mansoorzamankhan/LORAWAN_project/Reports/2023-05-19 LoraWan Project Weekly Repot.docx

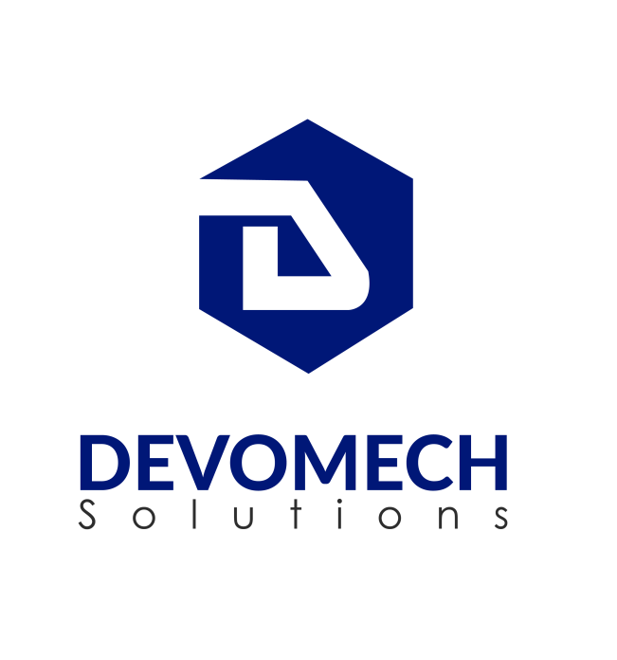
[picture p1: figure]

LORAWAN PROJECT

By:

Devomech Solutions Pvt. Ltd.

Date: 19-05-2023

# Current Progress:

1) The radiolib Arduino library was tested with rfm95 module transmitter and receiver.
2) The RSSI/received signal strength was very low as compared to the Lora library.

Library | RSSI | Encryption
Radiolib | -92dBm | No
Lora | -16dBm | Yes

# Task for Next Week

- Resolve the current connectivity issues.
- Test the radioLib library on the new module (1w breakout) .

Page 2 of 2 Confidential

LORAWAN PROJECT
