mansoorzamankhan/LORAWAN_project/Documents/lora-rfm-long-range-transceiver-shield-915-mhz-north-america-schematic.pdf

# GND +³V3

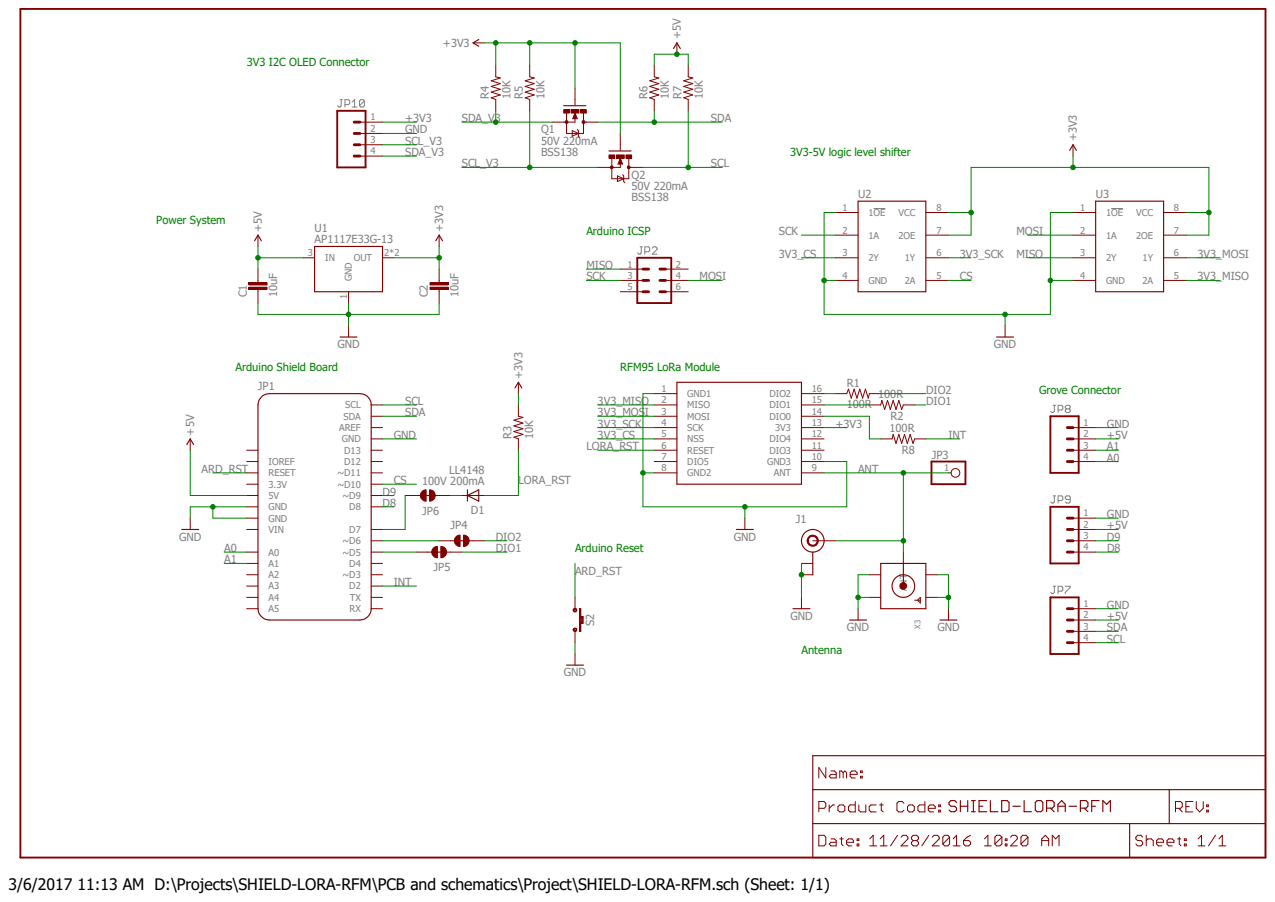
[picture p4: page 1]

3/6/2017 11:13 AM D:\Projects\SHIELD-LORA-RFM\PCB and schematics\Project\SHIELD-LORA-RFM.sch (Sheet: 1/1)
