mansoorzamankhan/LORAWAN_project/Documents/flow diagram.pdf

# SERVER

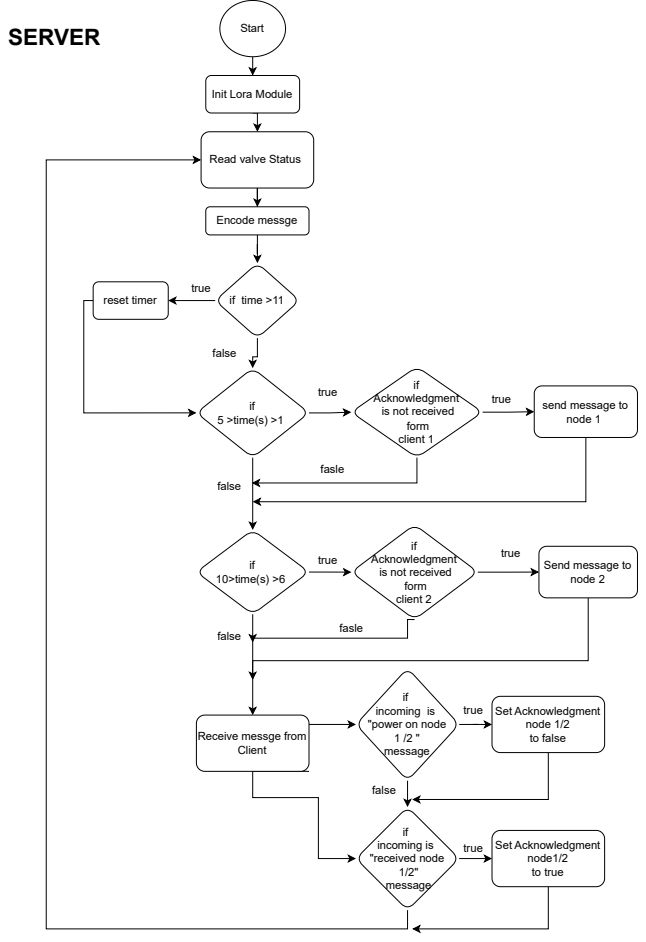
[picture p5: page 1]
Start; Encode messge; reset timer; if time >11; if 5 >time(s) >1; if 10>time(s) >6; true; false; fasle; Client; fasle false; if incoming is "power on node 1 /2 " message; Set Acknowledgment node 1/2 to false; if incoming is "received node 1/2" message; Set Acknowledgment node1/2 to true

Init Lora Module

Read valve Status

Acknowledgment
is not received
form
client 1

send message to
node 1

client 2

Send message to
node 2

Receive messge from

CLIENT | Start

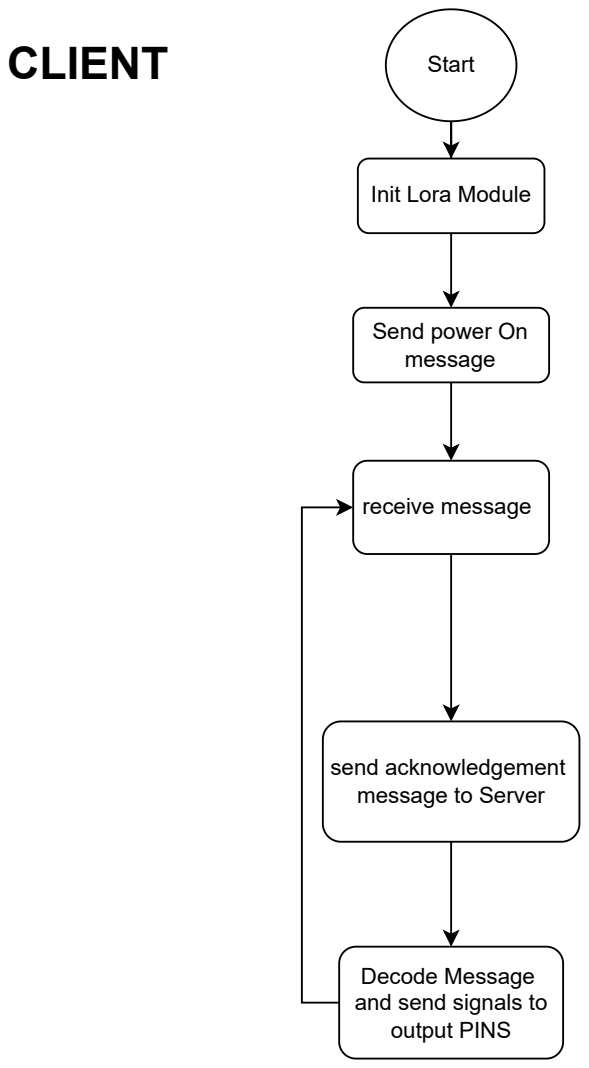
[picture p6: page 2]
receive message

Init Lora Module

Send power On
message

send acknowledgement
message to Server

Decode Message
and send signals to
output PINS
