mansoorzamankhan/LORAWAN_project/Code/testCodes/radiolib/Single_Node/server/server.ino

/*
   RadioLib SX127x Transmit Example

   This example transmits packets using SX1278 LoRa radio module.
   Each packet contains up to 256 bytes of data, in the form of:
    - Arduino String
    - null-terminated char array (C-string)
    - arbitrary binary data (byte array)

   Other modules from SX127x/RFM9x family can also be used.

   For default module settings, see the wiki page
   https://github.com/jgromes/RadioLib/wiki/Default-configuration#sx127xrfm9x---lora-modem

   For full API reference, see the GitHub Pages
   https://jgromes.github.io/RadioLib/
*/

// include the library
#include <RadioLib.h>

// SX1278 has the following connections:
// NSS pin:   10
// DIO0 pin:  2
// RESET pin: 9
// DIO1 pin:  3
SX1278 radio = new Module(10, 2, 9, 3);//for arduino 
//SX1278 radio = new Module(5, 2, 4, 12); // for esp32 

// or using RadioShield
// https://github.com/jgromes/RadioShield
//SX1278 radio = RadioShield.ModuleA;

void setup() {
  Serial.begin(9600);

  // initialize SX1278 with default settings
  Serial.print(F("[SX1278] Initializing ... "));
  int state = radio.begin();
  if (state == RADIOLIB_ERR_NONE) {
    Serial.println(F("success!"));
  } else {
    Serial.print(F("failed, code "));
    Serial.println(state);
    while (true);
  }

  // some modules have an external RF switch
  // controlled via two pins (RX enable, TX enable)
  // to enable automatic control of the switch,
  // call the following method
  // RX enable:   4
  // TX enable:   5
  /*
    radio.setRfSwitchPins(4, 5);
  */
}

void loop() {
  Serial.print(F("[SX1278] Transmitting packet ... "));

  // you can transmit C-string or Arduino string up to
  // 256 characters long
  // NOTE: transmit() is a blocking method!
  //       See example SX127x_Transmit_Interrupt for details
  //       on non-blocking transmission method.
  int state = radio.transmit("Hello World!");

  // you can also transmit byte array up to 256 bytes long
  /*
    byte byteArr[] = {0x01, 0x23, 0x45, 0x67, 0x89, 0xAB, 0xCD, 0xEF};
    int state = radio.transmit(byteArr, 8);
  */

  if (state == RADIOLIB_ERR_NONE) {
    // the packet was successfully transmitted
    Serial.println(F(" success!"));

    // print measured data rate
    Serial.print(F("[SX1278] Datarate:\t"));
    Serial.print(radio.getDataRate());
    Serial.println(F(" bps"));

  } else if (state == RADIOLIB_ERR_PACKET_TOO_LONG) {
    // the supplied packet was longer than 256 bytes
    Serial.println(F("too long!"));

  } else if (state == RADIOLIB_ERR_TX_TIMEOUT) {
    // timeout occurred while transmitting packet
    Serial.println(F("timeout!"));

  } else {
    // some other error occurred
    Serial.print(F("failed, code "));
    Serial.println(state);

  }

  // wait for a second before transmitting again
  delay(1000);
}
