mansoorzamankhan/LORAWAN_project/(commit log)

2023-04-03 one way multiple nodes comunication done on esp32
2023-04-10 input output periferals
    enceded the digital read values of valves at server and decoded them at the client end
2023-04-11 comunication test
    to test on arduino shiled
    ss=10
    rst=7
    dio=2
2023-05-22 radiolib for arduino
2023-05-25 update valve status and upload it to client side
2023-05-31 ON,OFF logic changed
    on 11
    off 10
    added test code for valves as well
2023-06-23 client server tested with valve test with irrigation channel
